Opulinks-Tech/OPL1000-HDK/README.md

# OPL1000-HDK  
旺凌科技官方 OPL1000 硬件参考设计资源库

內容:

- COB: Chip-on-Board 参考设计目录
- Module: 模块参考设计目录
- OPL1000-DS-NonNDA.pdf: OPL1000 Datasheet Non-NDA 版本
- OPL1000-HDK Development Guide_UG1-01-1.1.pdf: HDK 说明及介绍文档
- OPL1000-HDK_ENG.pdf: HDK 英文版本说明及介绍文档  
- OPL1200-DataSheet-NonNDA.pdf: OPL1200 Datasheet Non-NDA 版本

---  

Opulinks official hardware development kit for OPL1000.

Content:

- COB: Chip-on-Board reference design
- Module: Modules reference design
- OPL1000-DS-NonNDA.pdf: OPL1000 Datasheet Non-NDA version
- OPL1000-HDK Development Guide_UG1-01-1.1.pdf: HDK document
- OPL1000-HDK_ENG.pdf: HDK document in English
- OPL1200-DataSheet-NonNDA.pdf: OPL1200 Datasheet Non-NDA version
