Opulinks-Tech/OPL1000-HDK/COB/Readme.md

## Content Description

COB:

COB_min: The minimum BOM HDR of OPL1000 COB without flash

History: The previous versions of HDR for reference

#

COB方案:

COB_min: OPL1000 COB 不帶Flash最少零件版本

History: 歷史版本存放區
