Opulinks-Tech/OPL1000-HDK/Module/Readme.md

## 模塊方案:

**OPL1X00 HDK開發指南** | **[Download Link](https://github.com/Opulinks-Tech/OPL1000-HDK/blob/master/OPL1000-HDK%20Development%20Guide_UG1-01-3.pdf)** | 

**OPL1xxx HW Design check list** | **[Download Link](https://github.com/Opulinks-Tech/OPL1000-HDK/blob/4ce38aaee000ceaa7d13c025b06e39733aeb79d7/OPL1xxx%20HW%20Design%20check%20list_V1.0.xlsx)** | 

**OPL1800 模塊組合表*(3邊pin)**
| **HDK 版本** | **V01** | 
| --- |---|
| **兼容性** | **D566**  |
| **性能版** | **[D566L_V01](https://github.com/Opulinks-Tech/OPL1000-HDK/blob/master/Module/OPL1600_EXTLDO.rar)** |  
| **最佳功耗與成本版** |**[D566D_V01](https://github.com/Opulinks-Tech/OPL1000-HDK/blob/master/Module/OPL1600_Internal.rar)** | 

**OPL1000 模塊組合表**
| **HDK 版本** | **V15** |
| --- |---|
| **兼容性** | **D566**  |
| **性能版** | **[D566L_V15](https://github.com/Opulinks-Tech/OPL1000-HDK/raw/master/Module/OPL1000A2_D566L_EXLDO.rar)** |
| **最佳功耗與成本版** |**[D566D_V15](https://github.com/Opulinks-Tech/OPL1000-HDK/raw/master/Module/OPL1000A2_D566D_Internal.rar)** | 

**OPL1200 模塊組合表(3邊pin)**  
| HDK 版本  |  V02  |
| --- |  --- |
| **性能版**| **[OPL1200L](https://github.com/Opulinks-Tech/OPL1000-HDK/raw/master/Module/OPL1200A2_D566L_EXLDO_V2.rar)**|
  
**OPL1200 球泡燈通用模组**  
| **HDK 版本** | **V3** |
| ---  |  ---|
|  **連結** |  **[smart_lighting_V3](https://github.com/Opulinks-Tech/OPL1000-HDK/raw/master/Module/OPL1200A2-smart_lighting_V3.rar)**|

## 最新模塊說明
* D566D_V15/ D566L_V15/ OPL1200L_V02(3邊pin版本)/ smart lighting_V3 為最新版本  
    
* OPL1200A2:  
  1. OPL1200 模塊参考設計 (基於OPL1000上，内嵌flash)  
  
* Light_OPL1200 
  1. OPL1200球泡燈4層板通用模组  
  
---
Driver_Tool: USB-to-UART 驅動工具

History: 歷史版本存放區
