Opulinks-Tech/OPL1000-HDK/COB/COB_min_v1/BOM/OPL1000A2_chip on board module(min size)_2019_05_27_EXLDO V1.xlsx

Item | Sub assembly | Quantity | part reference | Value | PCB Footprint | Source Package | Mounting_Type | PartSafety | PartTempRng | Description | Manufacturer | Manu PID
1 | * | 1 | CN1 | IPEX | ANTS-1.3 | IPEX_0 | SMD | Pb-Free/RoHS | C | IPEX RF Connector | Alifecom | RH39801
2 | * | 2 | C2,C3 | 27pF+/-1%/50V | C0402 | CAPACITOR | SMD | Pb-Free/RoHS | C | Cap 27pF/50V ±1% NPO 0402 | YAGEO | CC0402FPNPO9BN270
3 | * | 1 | C5 | 0.5pF+/-0.1pF/50V | C0402 | CAPACITOR | SMD | Pb-Free/RoHS | C | 0.5pF+/-0.1pF/50V | MURATA | GJM1555C1HR50BB01
4 | * | 1 | C30 | 0.1uF±1%/16V | C0201 | CAPACITOR | SMD | Pb-Free/RoHS | C | Cap 0.1uF/16V ±1% X5R 0201 | YAGEO | CC0201KRX5R7BB104
5 | * | 3 | C68,C80,C82 | 4.7uF+/-10%/10V | C0402 | CAPACITOR | SMD | Pb-Free | C | Cap4.7uF/10V±10% X5R 0402 | YAGEO | CC0402MRX5R5BB475
6 | * | 2 | C79,C81 | 1uF/16V ±10% | C0402 | CAPACITOR | SMD | Pb-Free | C | Cap 1uF/16V ±10% X5R 0402 | TDK | C1005X5R1C105KT
7 | * | 1 | R4 | 0 ohm | R0402 | RESISTOR | SMD | Pb-Free | C | 0 ohm 1/16W 0402 | YAGEO | RC0402JR-070RL
8 | * | 1 | U1 | OPL1000A1 | QFN48 | OPL1000A0_2 | SMD | Pb-Free/RoHS | C | WiFi/BLE | NetLink | OPL1000A0
9 | * | 1 | U6 | RT9063-12GVN | SOT-23-3 (N) | RT9063-12GVN | SMD | Pb-Free/RoHS | C | IC LDO Regulator fix 1.2V 250mA RT9063-12GVN SOT23-3(N) RICHTEK | RICHTEK | RT9063-12GVN
10 | * | 1 | Y1 | 22MHz+-10ppm | SMD2520 | XTAL_0 | SMD | Pb-Free/RoHS | C | 22MHz ±10ppm 10pF <50R ; CL cap user:27 pf | Abracon LLC | ABM10W-22.0000MHZ-4-B1U-T3
 | S | 0 |  | 22MHz+-10ppm | SMD3225 | XTAL_0 | SMD | Pb-Free/RoHS | C | 22MHz ±10ppm 10pF 60R ; CL cap user:15pf | TXC | TXC 7M22000001
 | S | 0 |  | 22MHz+-10ppm | SMD3225 | XTAL_0 | SMD | Pb-Free/RoHS | C | 22MHz ±10ppm 10pF 60R ; CL cap user:24pf | SIWARD | SIWARD XTL571200-S417-005
