Opulinks-Tech/OPL1000-HDK/OPL1xxx HW Design check list_V1.0.xlsx

Sheet: Version
日期 | 描述 | 版本
2024-05-29 | 新建立 | V1.0

Sheet: Ext. LDO Circuit Check Lis
OPL1xxx HW design check list
Check Items |  |  | Check Lists |  | Comments / Ref | Check | Links/Notes
1. Power and Ground
 | 1.1 | VBAT
 |  |  | 1.1.1 | VBAT 需二顆去耦電容 ( 4.7uF + 0.1uF ) | Ref 1
 | 1.2 | VDD_PA
 |  |  | 1.2.1 | VDD_PA 需要二顆去耦電容 ( 4.7uF + 0.1uF )
 |  |  | 1.2.2 | VDD_PA 與 VBAT 同電壓，二者短路即可
 | 1.3 | VDDO (VDDIO)
 |  |  | 1.3.1 | VDDO1 需一顆去耦電容 ( up to 0.1uF ) | Ref 1
 |  |  | 1.3.2 | VDDO2 需一顆去耦電容 ( up to 4.7uF ) | Ref 1
 |  |  | 1.3.3 | VDDO1, VDDO2 與 VBAT 同電壓
 |  |  | 1.3.4 | 如與其它裝置工作電壓不同，VDDO1, VDDO2 可與其它裝置同電壓，讓雙方 GPIO 有相同電壓位準 | Ref 5
 | 1.4 | External LDO
 |  |  | 1.4.1 | 建議線路請參照 Ref 1 | Ref 1
 |  |  | 1.4.2 | SMPS_IND1 用於控制 LDO_EN，便於在睡眠模式下更省電 | Ref 1
 | 1.5 | VDD_RF
 |  |  | 1.5.1 | VDD_RF 需要二顆去耦電容 ( 4.7uF + 0.1uF) | Ref 1
 | 1.6 | Ground
 |  |  | 1.6.1 | EPAD 連接至 Ground | Ref 1
 |  |  | 1.6.2 | VSS_PMU 連接至 Ground | Ref 1
2. Enable, Reset and Clcok
 | 2.1 | RST_N / PWR_ONpin
 |  |  | 2.1.1 | 需 RC 來延遲開機時間，請參照 Ref 7 | Ref 7
 |  |  | 2.1.2 | 可利用外部 GPIO 控制 PWR_ON 訊號，可降低功秏 | Ref 7
 |  |  | 2.1.3 | 如使用乾電池直接供電，需避免電池彈跳所造成的異常，建議增加 RST 芯片
 | 2.2 | External crystals
 |  |  | 2.2.1 | 晶振 32.768kHz 的規格與電路，參考 Ref 9 | Ref 8 |  | 1. TEF322T32K7680R 2. XTL721-S349-005
 |  |  | 2.2.2 | 晶振 22MHz 的規格與電路，參考 Ref 10 | Ref 9 |  | 1. S2520A-022000-T10-BCD-1AZA 2. SX25Y022000BA1TLWA
 |  |  | 2.2.3 | 如產品無特殊溫度需求，溫度選用“商規”即可
3. GPIOs
 | 3.1 | usages of GPIO ( Check if GPIO can be in an undefined state - example, 訊迪單火線use one GPIO to control relay and LED; a voltage divider exists causing issue. )
 |  |  | 3.1.1 | Functions of IO0, 燒錄腳位，請留測試點 |  |  | APS_DBG_UART_TX
 |  |  | 3.1.2 | Functions of IO1, 燒錄腳位，請留測試點 |  |  | APS_DBG_UART_RX
 |  |  | 3.1.3 | Functions of IO2, internal pull-up
 |  |  | 3.1.4 | Functions of IO3, internal pull-down
 |  |  | 3.1.5 | Functions of IO4, internal pull-up
 |  |  | 3.1.6 | Functions of IO5, internal pull-up
 |  |  | 3.1.7 | IO6 是設定芯片的腳位，禁止當輸入使用，internal pull-down |  |  | 使用此 IO，其初始硬件設定須為低電位
 |  |  | 3.1.8 | Functions of IO7, internal pull-up
 |  |  | 3.1.9 | Functions of IO8, internal pull-down
 |  |  | 3.1.10 | Functions of IO9, internal pull-up
 |  |  | 3.1.11 | Functions of IO10, internal pull-up
 |  |  | 3.1.12 | Functions of IO11, internal pull-up
 |  |  | 3.1.13 | Functions of IO12, 需一顆上拉電阻 4.7k ohm | Ref 10 |  | SPI0_Master_CS
 |  |  | 3.1.14 | Functions of IO13, connect to Flash_SCLK | Ref 10 |  | SPI0_Master_CLK, can connect external flash in parallel
 |  |  | 3.1.15 | Functions of IO14, connect to Flash_MOSI | Ref 10 |  | SPI0_Master_MOSI, can connect external flash in parallel
 |  |  | 3.1.16 | Functions of IO15, connect to Flash_MISO | Ref 10 |  | SPI0_Master_MISO, can connect external flash in parallel
 |  |  | 3.1.17 | Functions of IO16, internal pull-up
 |  |  | 3.1.18 | Functions of IO17, internal pull-down
 |  |  | 3.1.19 | Functions of IO18, internal pull-up | Ref 33 |  | M0_ICE_CLK, Ref 33 for ICE ref circuit
 |  |  | 3.1.20 | Functions of IO19, internal pull-down | Ref 33 |  | M0_ICE_DAT, Ref 33 for ICE ref circuit
 |  |  | 3.1.21 | Functions of IO20, internal pull-up | Ref 33 |  | M3_ICE_DAT, Ref 33 for ICE ref circuit
 |  |  | 3.1.22 | Functions of IO21, internal pull-down | Ref 33 |  | M3_ICE_CLK, Ref 33 for ICE ref circuit
 |  |  | 3.1.23 | Functions of IO22, internal pull-up
 |  |  | 3.1.24 | Functions of IO23, internal pull-down
 |  |  | 3.1.25 | Functions of Flash_SCLK, connect to IO13 | Ref 10 |  | internal flash pin, SPI_SLAVE_CLK
 |  |  | 3.1.26 | Functions of Flash_MISO, connect to IO15 | Ref 10 |  | internal flash pin, SPI_SLAVE_MISO
 |  |  | 3.1.27 | Functions of Flash_MOSI, connect to IO14 | Ref 10 |  | internal flash pin, SPI_SLAVE_MOSI
4. ADC
 | 4.1 | ADC for voltage monitoring
 |  |  | 4.1.1 | 如需準確的判讀電壓，在產品生產時，須要二次校準，以提高精準度，此時請留測試點，以利生產 |  |  | 芯片在生產時已校準
 |  |  | 4.1.2 | 量測電池電壓，需選用高阻值且誤差值 1% 的電阻，以降低功秏 ( up to 500k ohm )
 |  |  | 4.1.3 | 可增加電子開關，用來關閉分壓電阻造成的功秏 | Ref 11
 | 4.2 | ADC for sensor
 |  |  | 4.2.1 | 隨耦器用於阻抗隔離和擴大 ADC 動態偵測範圍 | Ref 12
5. RF matching
 | 5.1 | Antenna match and RF match
 |  |  | 5.1.1 | RF match 參考電路 | Ref 13
 |  |  | 5.1.2 | Antenna match 參考電路 | Ref 13 |  | 1. PCB天線與 I-PEX 連接器，只能二選一，不可同時使用 2. 外置天線的性能，請天線廠處理，電路上無法提供協助
 |  |  | 5.1.2 | RF電路，請完全依照我司電路，以避免安規無法調適的問題
6. Module
 | 6.1 | 模組腳位規劃
 |  |  | 6.1.1 | 靠近 RF 天線的位置，請規劃 GND PIN
 |  |  | 6.1.2 | 靠近天線的位置，不應規劃高頻信號，如PWM、SPI…..等等
 |  |  | 6.1.3 | 數位與類比信號應分開，避免類比信號被干擾
7. Other
 | 7.1 | 連接器
 |  |  | 7.1.1 | 連接器的接腳，若有腳位沒使用，請連接 GND，避免雜散電容產生
 | 7.2 | 電容
 |  |  | 7.2.1 | 確認各電容的耐壓值是否足夠
 | 7.3 | 電阻
 |  |  | 7.3.1 | 電源所需的電阻，請選用誤差值 1% 之電阻，如調整 LDO 輸出電壓之電阻
 |  |  | 7.3.2 | 功率大的電路，需確認電阻包裝大小
 | 7.4 | 磁珠
 |  |  | 7.4.1 | 磁珠的挑選，應以電流為主，阻抗為輔 |  |  | 磁珠的過電流應為電路電流的1.5~2倍
 | 7.5 | LDO / DC-DC
 |  |  | 7.5.1 | 外部電源的挑選，電源芯片提供之電流，必須是系統電流的 1.5 ~ 2倍，建議使用 600mA 以上的電源芯片 |  |  | 因 RF hopping 的關係，RF_TX 開關頻繁，在 TX 打開的時候，瞬間電流較大，因而需要選用大於系統電流之芯片
 |  |  | 7.5.2 | 電源雜訊須小於 100mV ( RF 進入測試模式時 ) |  |  | 請查閱各芯片之規格書

Sheet: Layout Check List
OPL1xxx Layout check list
Check Items |  |  | Check Lists |  | Comments / Ref | Check |  | Links/Notes
1. Footprint
 | 1.1 | QFN
 |  |  | 1.1.1 | QFN包裝，在芯片的底下有 e-PAD，在這區域的 TOP 層與 Bottom 層皆需打開防焊層 | Ref 14 |  | FALSE
 |  |  | 1.1.2 | e-Pad 需增加貫穿孔，可讓多餘的錫引流避免芯片短路，也可增加散熱 | Ref 15 |  | FALSE
 | 1.2 | I-PEX
 |  |  | 1.2.1 | I-PEX 連接器，所有層面都禁止鋪銅 | Ref 16 |  | FALSE
 | 1.3 | Module outline
 |  |  | 1.3.1 | 模組腳位在 Bottom 層需加大，以利在生產測試時，方便頂針連接測試與燒錄 | Ref 17 |  | FALSE
 |  |  | 1.3.2 | Bottom PAD 大小與選用之頂針相關 |  |  | FALSE
2. Shielding
 | 2.1 | 屏蔽殼
 |  |  | 2.1.1 | 除了 Antenna match 所需之元件外，其餘元件皆應受屏蔽罩保護 | Ref 18 |  | FALSE
 |  |  | 2.1.2 | Shielding cover 需增加 GND via，增強其屏蔽能力 |  |  | FALSE
3. Power and Ground
 | 2.1 | 電源
 |  |  | 2.1.1 | 銅泊厚度 1oz，電源線寬 15mil，其耐電流約 500mA |  |  | FALSE
 |  |  | 2.1.2 | Power Plane 必須比 GND Plane 面積小 | Ref 19 |  | FALSE
 |  |  | 2.1.3 | 電源走線以樹枝狀為最佳，將負載大與負載小的電源分開 | Ref 20 |  | FALSE
 |  |  | 2.1.4 | 去耦電容必須靠近 IC，並且注意電源行進的順序，要先經過電容，再由電容供給 IC | Ref 21 |  | FALSE
 |  |  | 2.1.5 | 電源源頭至各分支電源，請使用星狀分散各電源，可避免各路電源互相干擾 | Ref 22 |  | FALSE | 適用於電源轉換後，至各芯片或裝置之電源 (主電源)
 |  |  | 2.1.6 | 電源走線，請用樹枝狀方式，不要用串接方式 | Ref 23 |  | FALSE | 適用於芯片或裝置內部之電源 (分支電源)
 |  |  | 2.1.7 | 電源電路及 DC-DC switching regulator 相關路徑，必須考慮IC的迴路電流，線寬、鋪銅面積，及最短路徑接地 |  |  | FALSE
 |  |  | 2.1.8 | 銅厚 1 oz，且 VIA 孔徑 8 mil，此時 VIA 可流過的電流約為 300 mA 左右 |  |  | FALSE
 |  |  | 2.1.9 | VBAT 最大瞬間電流為 500 mA |  |  | FALSE
 | 2.2 | 接地
 |  |  | 2.2.1 | 芯片底下不鋪銅 (GND Plane) |  |  | FALSE
 |  |  | 2.2.2 | VSS_PMU 不可與 EPAD 直接連接，需經過 VIA 連接 | Ref 24 |  | FALSE
 |  |  | 2.2.3 | 內層銅鉑須完整，禁止死銅（孤島）的情況產生，有斷銅的情況，皆是死銅（用 VIA 連接其它層面也算） | Ref 25 |  | FALSE
4. RF signal
 | 4.1 | RF and Antenna
 |  |  | 4.1.1 | RF信號皆要50Ω阻抗，可請PCB板廠協助計算，也可自行透過軟體計算，設定線寬與線距等等，進行Layout | Ref 26 |  | FALSE
 |  |  | 4.1.2 | RF 信號在第一層，第二層則必須是GND層，且GND Plane需保持完整 |  |  | FALSE
 |  |  | 4.1.3 | RF信線如有彎角必須是圓弧，都在同一層面 | Ref 27 |  | FALSE
 |  |  | 4.1.4 | RF 信號週圍，佈置大量 GND VIA | Ref 27 |  | FALSE
 |  |  | 4.1.5 | 負載大之電源及高頻訊須遠離RF信號與天線 |  |  | FALSE
 |  |  | 4.1.6 | PCB 天線需對應相同的 GND 信號 | Ref 28 |  | FALSE
5. Other
 | 5.1 | 晶振
 |  |  | 5.1.1 | 晶振儘量靠近IC，並遠離大電流電源及高頻訊號 |  |  | FALSE
 |  |  | 5.1.2 | 晶振底下，不可以走線，晶振信號除外 |  |  | FALSE
 | 5.2 | 走線
 |  |  | 5.2.1 | 走線時，不可有銳角 | Ref 29 |  | FALSE
 |  |  | 5.2.2 | 相鄰的二層走線時，不可平行與重疊，如空間不足，則需拉開間距，避免互相干預 | Ref 30 |  | FALSE
 |  |  | 5.2.3 | 類比信號應遠離高頻與大電流之信號 |  |  | FALSE
 |  |  | 5.2.4 | 重要信號需包覆 GND 並在兩側佈置大量的 GND VIA | Ref 31 |  | FALSE
 |  |  | 5.2.5 | Layout 完成，要修整走線，可增加 GND Plane 面積 |  |  | FALSE
 | 5.3 | 元件擺放
 |  |  | 5.3.1 | 元件位置要標齊對正，XY座標不要有小數點 (單位 mil)，除了機構件之外，最好以 5mil 為格點，來擺放元件 | Ref 32 |  | FALSE

Sheet: Ref_Power_Circuit
Ref 1

Sheet: Ref
Ref 3
Ref 5
Ref 6
Ref 7
Ref 8
Ref 9
Ref 10
Ref 11 | 分壓計算
Ref 12
Ref 13
Ref14
Ref 15
Ref 16
Ref 17
Ref 18
Ref 19
Ref 20
Ref 21
Ref 22
Ref 23
Ref 24
Ref 25
Ref 26
Ref 27
Ref 28
Ref 29
Ref 30
Ref 31
Ref 32
Ref 33
Ref 34
Ref35
Ref 36
Ref 37
Ref 38
Ref 39
Ref 40

Sheet: 分壓計算
Vout = | [ Vin / ( R1+R2 ) ] * R1 |  |  | Vin | 3 | Vout = | [ Vin / ( R1+R2 ) ] * R1 |  |  | Vin | 4.2
MAX | 2.01329 |  |  |  |  | MAX | 2.81860
TYP | 2.00000 |  |  |  |  | TYP | 2.80000
MIN | 1.98662 |  |  |  |  | MIN | 2.78127
Values | R1 | R2 |  |  |  | Values | R1 | R2
 | 1000 | 2000 | k ohm |  |  |  | 1000 | 2000 | k ohm
1% | 1010 | 2020 |  |  |  | 1% | 1010 | 2020
-1% | 990 | 1980 |  |  |  | -1% | 990 | 1980
Vout = | [ Vin / ( R1+R2 ) ] * R1 |  |  | Vin | 1.8 | Vout = | [ Vin / ( R1+R2 ) ] * R1 |  |  | Vin | 3
MAX | 1.20797 |  |  |  |  | MAX | 2.01329
TYP | 1.20000 |  |  |  |  | TYP | 2.00000
MIN | 1.19197 |  |  |  |  | MIN | 1.98662
Values | R1 | R2 |  |  |  | Values | R1 | R2
 | 1000 | 2000 | k ohm |  |  |  | 1000 | 2000 | k ohm
1% | 1010 | 2020 |  |  |  | 1% | 1010 | 2020
-1% | 990 | 1980 |  |  |  | -1% | 990 | 1980
