Opulinks-Tech/OPL1000-HDK/(threads)

Thread 1 (2024-08-09):

OPL1000 SDK

divadiow, 2024-08-09:
Hello. Is the OPL1000A3-SDK the latest for all OPL1000 variants?

is this the latest version of the download tool?

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

and is it possible to dump firmware already on an OPL1000 to a file?
