Opulinks-Tech/OPL1000-HDK/COB/COB_min_v1/Schematic/OPL1000A2_chip on board module(min size)_20190527_EXLDO V1.pdf

5

4

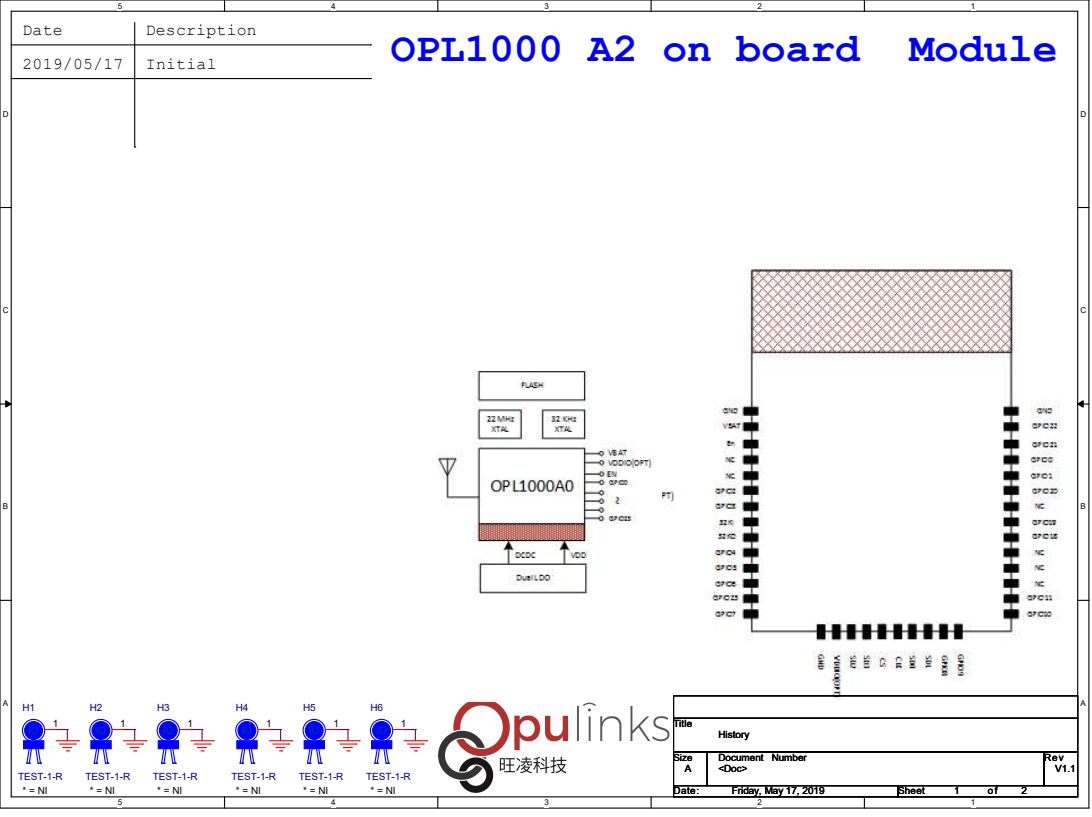
[picture p38: page 1]
Date; Description; Initial; OPL1000 A2 on board Module; Title; Size; Document Number; Rev; Date:; Sheet; o f <Doc>; V1.1 History A; Friday, May 17, 2019; 2 H6 TEST-1-R; 1 H1 TEST-1-R; H3 TEST-1-R; H5 TEST-1-R; 1 H2 TEST-1-R; H4 TEST-1-R

# Fix LDO output 1.2V

# J7 SIP14-1P27 * = NI 1

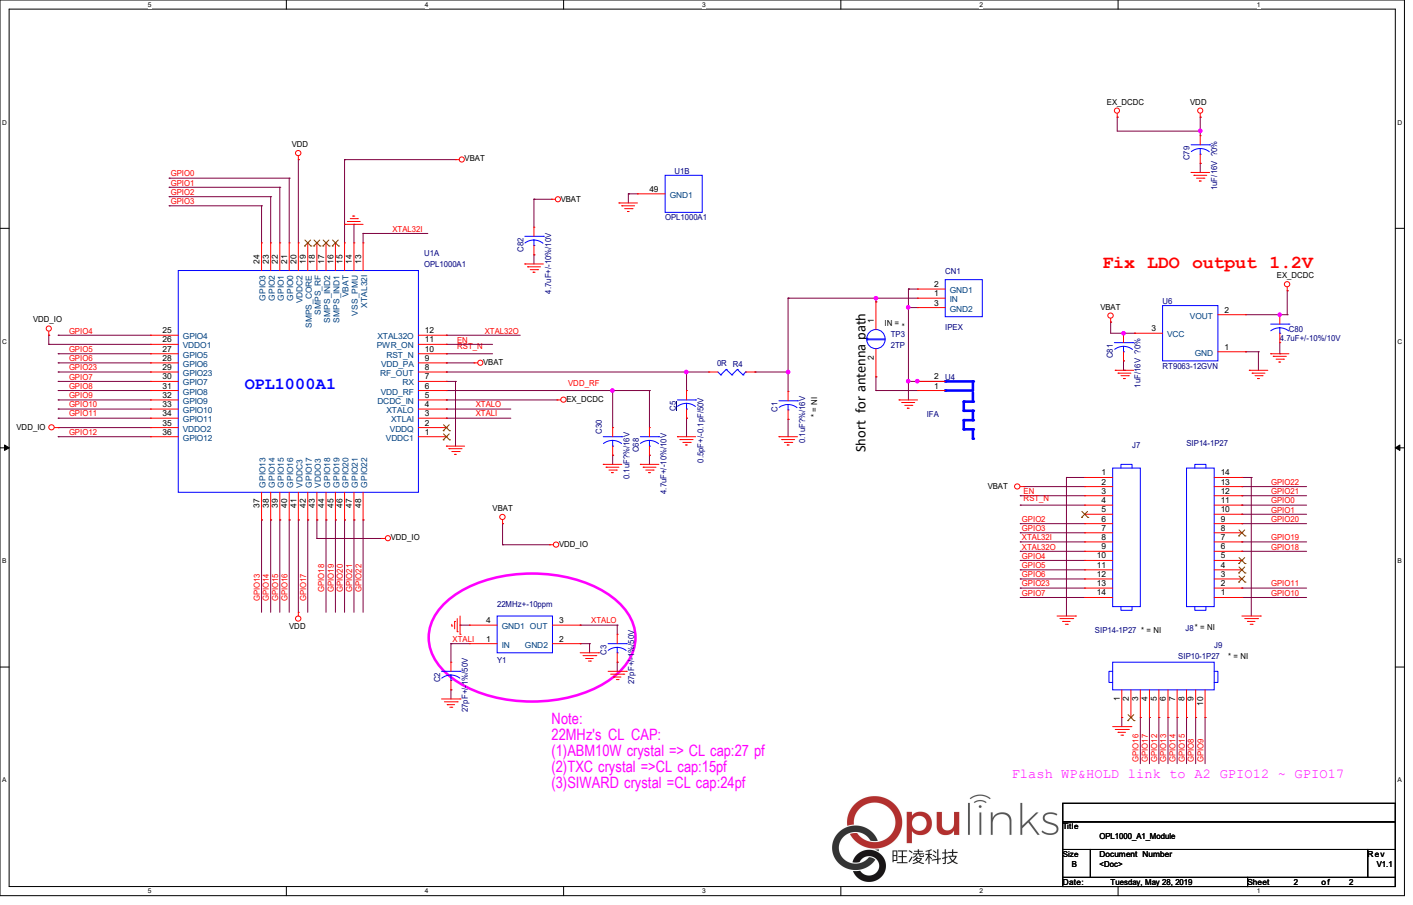
[picture p39: page 2]

A A Short for antenna path

Note:
22MHz's CL CAP:
(1)ABM10W crystal => CL cap:27 pf
(2)TXC crystal =>CL cap:15pf

Flash WP&HOLD link to A2 GPIO12 ~ GPIO17
