Opulinks-Tech/OPL1000-HDK/(list of files, drawings)

Other design files:
DevKit-HDK/D3/Module Board/Layout/OPL1000A0_Module_Monpole-2018-02-09.pcb
DevKit-HDK/D3/Module Board/Layout/OPL1000A1_Module_V1.2_2018_09_27.pcb
DevKit-HDK/D3/Module Board/Schematics/opl1000a0_module_monpole_2018_02_09.opj
DevKit-HDK/D3/Module Board/Schematics/OPL1000A1_MODULE_MONPOLE_2018_0626.OPJ
DevKit-HDK/D3/Mother Board/Layout/OPL1000A0_MotherBoard_DevKit.pcb
DevKit-HDK/D3/Mother Board/Layout/OPL1000A1_Module_Mother_V1.2_2018_09_27.pcb
DevKit-HDK/D3/Mother Board/Schematics/A1_MODULE_MOTHER_BOARD_2018_06_26.DSN
DevKit-HDK/D3/Mother Board/Schematics/a1_module_mother_board_2018_06_26.opj
DevKit-HDK/D3/Mother Board/Schematics/A1_MODULE_MOTHER_BOARD_V1_2_2018_10_02.DSN
DevKit-HDK/D3F/Module Board/Layout/OPL1000A1_Module_1.2E_2018_11_11.pcb
DevKit-HDK/D3F/Module Board/Layout/OPL1000A1_Module_1.2E_2018_12_22.pcb
DevKit-HDK/D3F/Module Board/Layout/OPL1000A1_Module_1.2E_2019_03_20.pcb
DevKit-HDK/D3F_v2/PADS/OPL1000A1_Module_1.2E_2018_12_22.pcb
DevKit-HDK/D3FP/Module Board/Layout/OPL1000A1_Module_1.2E_2018_12_03_IPEX.pcb
DevKit-HDK/D3FP_v2/Layout/OPL1000A1_Module_1.2E_2018_12_03_IPEX.pcb
DevKit-HDK/D3FV_v2/layout/OPL1000A1_MODULE_2019_04_15_EXLDO.pcb
DevKit-HDK/D3VF/Module board/Layout/OPL1000A1_Module_1.2E_2018_12_22_EXLDO.pcb
DevKit-HDK/D3VF/Module board/Layout/OPL1000A1_Module_1.2E_2019_02_14_EXLDO.pcb
DevKit-HDK/Module Board/Layout/OPL1000A0_Module_Monpole-2018-02-09.pcb
DevKit-HDK/Module Board/Layout/OPL1000A1_Module_V1.2_2018_09_27.pcb
DevKit-HDK/Module Board/Schematics/opl1000a0_module_monpole_2018_02_09.opj
DevKit-HDK/Module Board/Schematics/OPL1000A1_MODULE_MONPOLE_2018_0626.OPJ
DevKit-HDK/Module/D3F_v2/PADS/OPL1000A1_Module_1.2E_2018_12_22.pcb
DevKit-HDK/Module/D3FP_v2/Layout/OPL1000A1_Module_1.2E_2018_12_03_IPEX.pcb
DevKit-HDK/Module/D3FV_v2/layout/OPL1000A1_MODULE_2019_04_15_EXLDO.pcb
DevKit-HDK/Module/History/D3_v1/Module Board/Layout/OPL1000A1_Module_V1.2_2018_09_27.pcb
DevKit-HDK/Module/History/D3_v1/Mother Board/Layout/OPL1000A1_Module_Mother_V1.2_2018_09_27.pcb
DevKit-HDK/Module/History/D3_v1/Mother Board/Schematics/A1_MODULE_MOTHER_BOARD_V1_2_2018_10_02.DSN
DevKit-HDK/Module/History/D3F_v1/Module Board/Layout/OPL1000A1_Module_1.2E_2019_03_20.pcb
DevKit-HDK/Module/History/D3FP_v1/Module Board/Layout/OPL1000A1_Module_1.2E_2018_12_03_IPEX.pcb
DevKit-HDK/Mother Board/Layout/OPL1000A0_MotherBoard_DevKit.pcb
DevKit-HDK/Mother Board/Layout/OPL1000A1_Module_Mother_V1.2_2018_09_27.pcb
DevKit-HDK/Mother Board/Schematics/A1_MODULE_MOTHER_BOARD_2018_06_26.DSN
DevKit-HDK/Mother Board/Schematics/a1_module_mother_board_2018_06_26.opj
DevKit-HDK/Mother Board/Schematics/A1_MODULE_MOTHER_BOARD_V1_2_2018_10_02.DSN
HDK/Module/D3F_v2/PADS/OPL1000A1_MODULE_D3F_V2_20190522.pcb
HDK/Module/D3FP_v2/Layout/OPL1000A1_MODULE_D3FP_V2_IPEX_20190522.pcb
HDK/Module/D3FV_v2/layout/OPL1000A1_MODULE_D3FV_V2_EXLDO_20190522.pcb
HDK/Module/History/D3_v1/Module Board/Layout/OPL1000A1_Module_V1.2_2018_09_27.pcb
HDK/Module/History/D3_v1/Mother Board/Layout/OPL1000A1_Module_Mother_V1.2_2018_09_27.pcb
HDK/Module/History/D3_v1/Mother Board/Schematics/A1_MODULE_MOTHER_BOARD_V1_2_2018_10_02.DSN
HDK/Module/History/D3F_v1/Module Board/Layout/OPL1000A1_Module_1.2E_2019_03_20.pcb
HDK/Module/History/D3FP_v1/Module Board/Layout/OPL1000A1_Module_1.2E_2018_12_03_IPEX.pcb
