Opulinks-Tech/OPL1000-HDK/(commit log)

2018-05-28 update HDK
    [OPL1000A0_DevKit_BOM_2018_02_28.xlsx]
2018-07-02 update A1
    [A1_MODULE_MOTHER_BOARD_2018_06_26.DSN, OPL1000A1_MODULE_MONPOLE_2018_0626.OPJ, a1_module_mother_board_2018_06_26.opj]
2018-10-12 OPL1000 A1 updated
    [OPL1000A1_MODULE_MONPOLE_BOM.xlsx]
2019-01-08 Delete OPL1000_A0_ModuleBoard_BOM_2018_02_28.xlsx
    older informaiton
    [OPL1000_A0_ModuleBoard_BOM_2018_02_28.xlsx]
2019-01-08 Delete OPL1000A0_Module_Monpole-2018-02-09.pcb
    phased out
    [OPL1000A0_Module_Monpole-2018-02-09.pcb]
2019-02-15 OPL1000 A1 update
    [OPL1000A1_Module_1.2E_2019_02_15_EXLDO_BOM.xlsx]
2019-04-03 Delete OPL1000A1_Module_1.2E_2019_02_15_EXLDO_BOM.xlsx
    Remove Dual EXTLDO_BOM
    Owner: Nash
    [OPL1000A1_Module_1.2E_2019_02_15_EXLDO_BOM.xlsx]
2019-04-03 Add files via upload
    Add schematics of Single LDO module
2019-04-03 Delete OPL1000A1_MODULE_2019_02_14_EXLDO.DSN
    Delete schematics of OPL1000A1_MODULE_2019_02_14_EXLDO.DSN
    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
2019-04-03 Delete OPL1000A1_Module_1.2E_2019_02_14_EXLDO.pcb
    Remove OPL1000A1_Module_1.2E_2019_02_14_EXLDO.pcb
    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
    [OPL1000A1_Module_1.2E_2019_02_14_EXLDO.pcb]
2019-04-03 Add files via upload
    Add OPL1000A1_Module_1.2E_2019_04_01_EXLDO_BOM.xlsx
    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
    [OPL1000A1_Module_1.2E_2019_04_01_EXLDO_BOM.xlsx]
2019-04-03 Create BOM
2019-04-03 Create test
    Create BOM folder
2019-05-17 add A2 chip on board (external LDO) module
    [OPL1000A2_CHIP_ON_BOARD_MODULE_EXLDO.xlsx]
2019-05-21 Add files via upload
    The minimum BOM HDR of OPL1000 COB without flash. (OPL1000最少元件COB參考設計)
2019-05-21 The minimum BOM HDR of OPL1000 COB without flash
2019-05-21 HDR of OPL1000 module with flash and antenna
    [OPL1000A1_Module_1.2E_2018_12_22.pcb]
2019-05-21 HDR of OPL1000 module with flash, wthout antenna
    [OPL1000A1_Module_1.2E_2018_12_03_IPEX.pcb]
2019-05-21 HDR of OPL1000 module with flash, ant., single LDO
    [OPL1000A1_MODULE_2019_04_15_EXLDO.pcb]
2019-05-21 The module design of OPL1000
    [OPL1000A1_MODULE_2019_04_15_EXLDO.pcb, OPL1000A1_Module_1.2E_2018_12_03_IPEX.pcb, OPL1000A1_Module_1.2E_2018_12_22.pcb]
2019-05-22 OPL1000 HDK updated
    [A1_MODULE_MOTHER_BOARD_V1_2_2018_10_02.DSN, BOM-IPEX.xlsx, OPL1000A1_MODULE_2018_12_26_BOM.xlsx, OPL1000A1_MODULE_D3FP_V2_IPEX_20190522.pcb, OPL1000A1_MODULE_D3FV_V2_EXLDO_20190522.pcb, OPL1000A1_MODULE_D3F_V2_20190522.pcb, OPL1000A1_MODULE_MONPOLE_BOM.xlsx, OPL1000A1_Module_1.2E_2018_12_03_IPEX.pcb]
2019-07-23 Add files via upload
    HDR of OPL1000 module with flash and antenna (ESP-12F like)
2019-07-23 HDR of OPL1000 module with flash and antenna (ESP-12S like)
2019-07-23 HDR of OPL1000 module with flash and antenna (ESP-12F like)
2019-07-24 change to zip format
    [OPL1000A1_MODULE_D3FP_V2_IPEX_20190522.pcb, OPL1000A1_MODULE_D3FP_V2_IPEX_20190627.xlsx, OPL1000A1_MODULE_D3FV_V2_EXLDO_20190522.pcb, OPL1000A1_MODULE_D3FV_V2_EXLDO_20190627.xlsx, OPL1000A1_MODULE_D3F_V2_20190522.pcb, OPL1000A1_MODULE_D3F_V2_20190627.xlsx]
2019-07-24 D366S_V10_F Pull Up Resistor
2019-07-24 D366S_V10_S Pull Up Resistor
2019-07-24 HDR of OPL1000 module with flash, antenna, and single external LDO
2019-07-24 HDR of OPL1000 module with flash, without antenna
2019-07-24 HDR of OPL1000 module with flash and antenna (ESP-12F pin-to-pin compatible)
2019-07-24 HDR of OPL1000 module with flash and antenna (ESP-12S pin-to-pin compatible)
2019-08-07 HDR of OPL1000 module with flash, antenna, and single external LDO (ESP-12F pin-to-pin compatible)
2019-08-07 HDR of OPL1000 module with flash, antenna, and single external LDO (ESP-12S pin-to-pin compatible)
2019-12-31 reorgnize the directory HDK.
    [OPL1000A2_chip on board module(min size)_2019_05_27_EXLDO V1.xlsx]
2020-03-02 add ESP32_D3FV.rar
2020-03-11 renamed ESP32_D3FV to D332FV_V13
2020-06-16 update IND description in BOM and schematics
2020-10-21 update UART description & modified R178 0ohm to 1M ohm
2022-06-10 Update Readme.md
    OPL1600 Internal 模块
2024-07-08 Add files via upload
    OPL1xxx HW Design check list_V1.0.xlsx
    [OPL1xxx HW Design check list_V1.0.xlsx]
